vladiclick/emo-desk-robot/emo-complete/Emo-Complete-cutaway.png

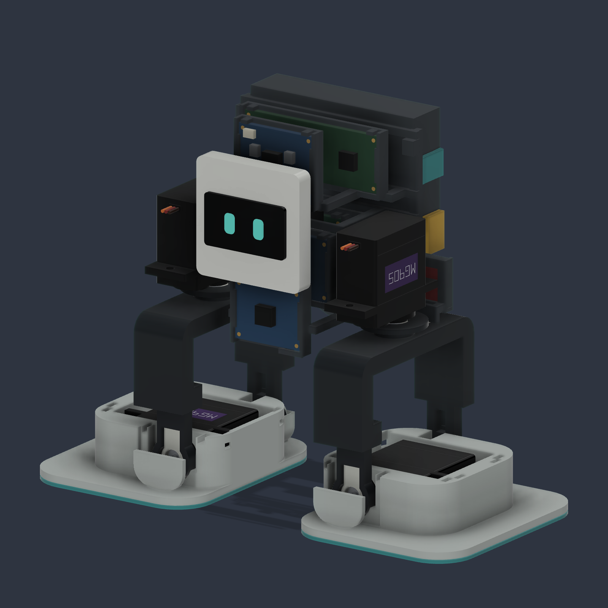
emo-complete/Emo-Complete-cutaway.png
