vladiclick/emo-desk-robot/emo-complete/Emo-Complete-mechanism.png

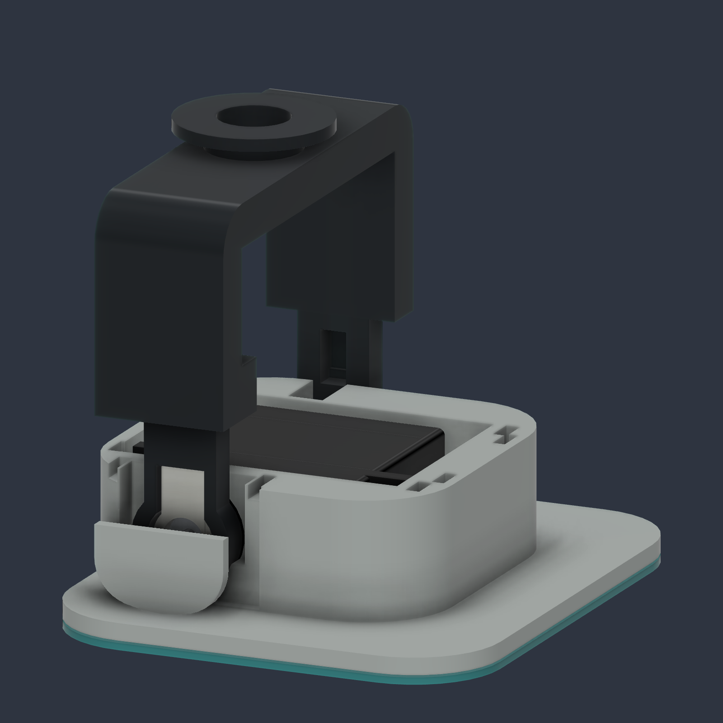
emo-complete/Emo-Complete-mechanism.png
