vladiclick/emo-desk-robot/emo-complete/Emo-Complete-motion.png

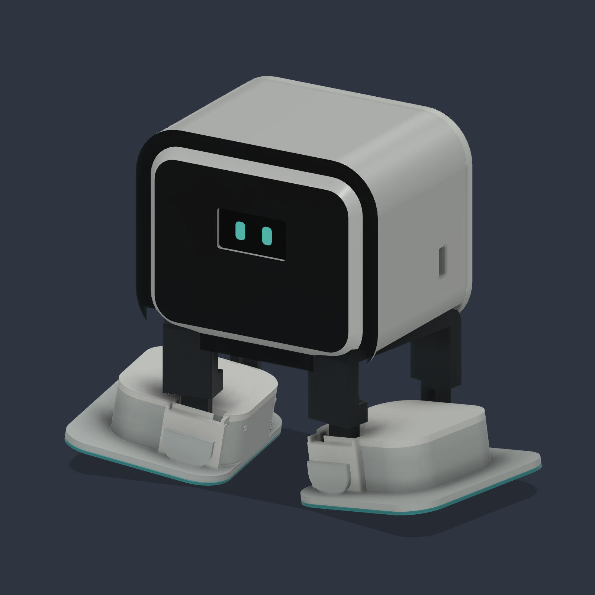
emo-complete/Emo-Complete-motion.png
