vladiclick/emo-desk-robot/emo-complete/Emo-Complete-rear.png

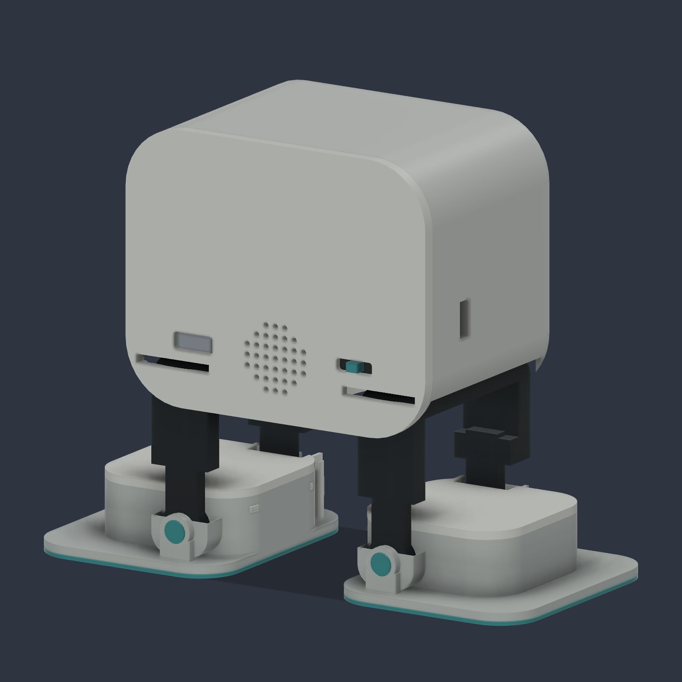
emo-complete/Emo-Complete-rear.png
