vladiclick/emo-desk-robot/emo-complete/Emo-Complete-service.png

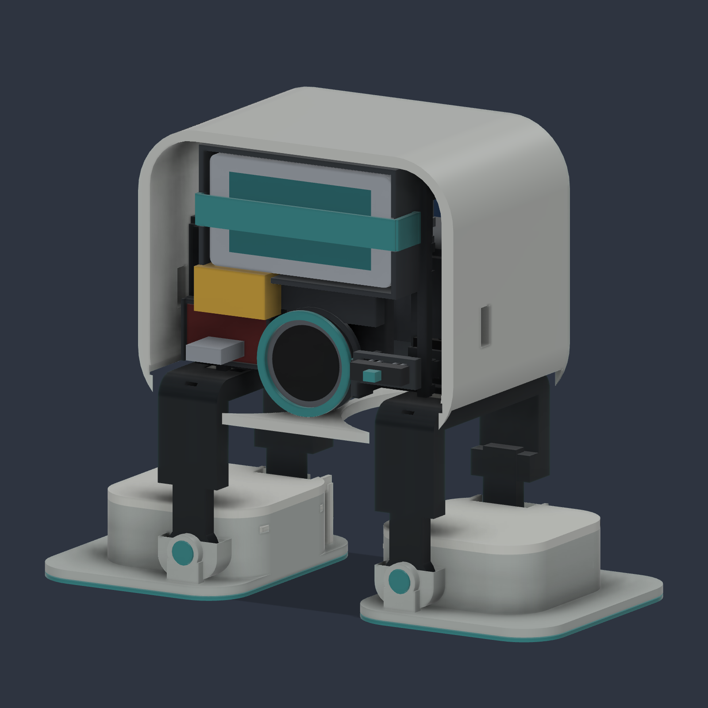
emo-complete/Emo-Complete-service.png
