vladiclick/emo-desk-robot/emo-complete/Emo-Complete-style-Night.png

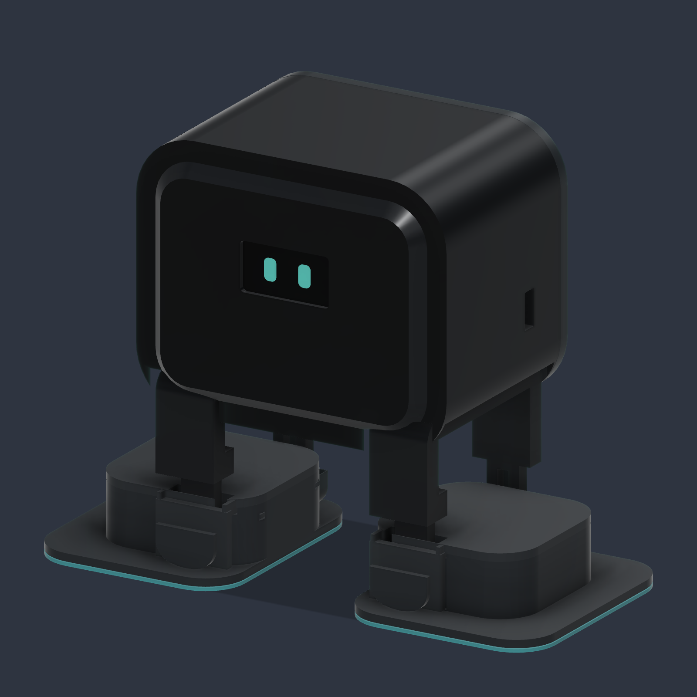
emo-complete/Emo-Complete-style-Night.png
