vladiclick/emo-desk-robot/figurine/EMO_52min_preview.png

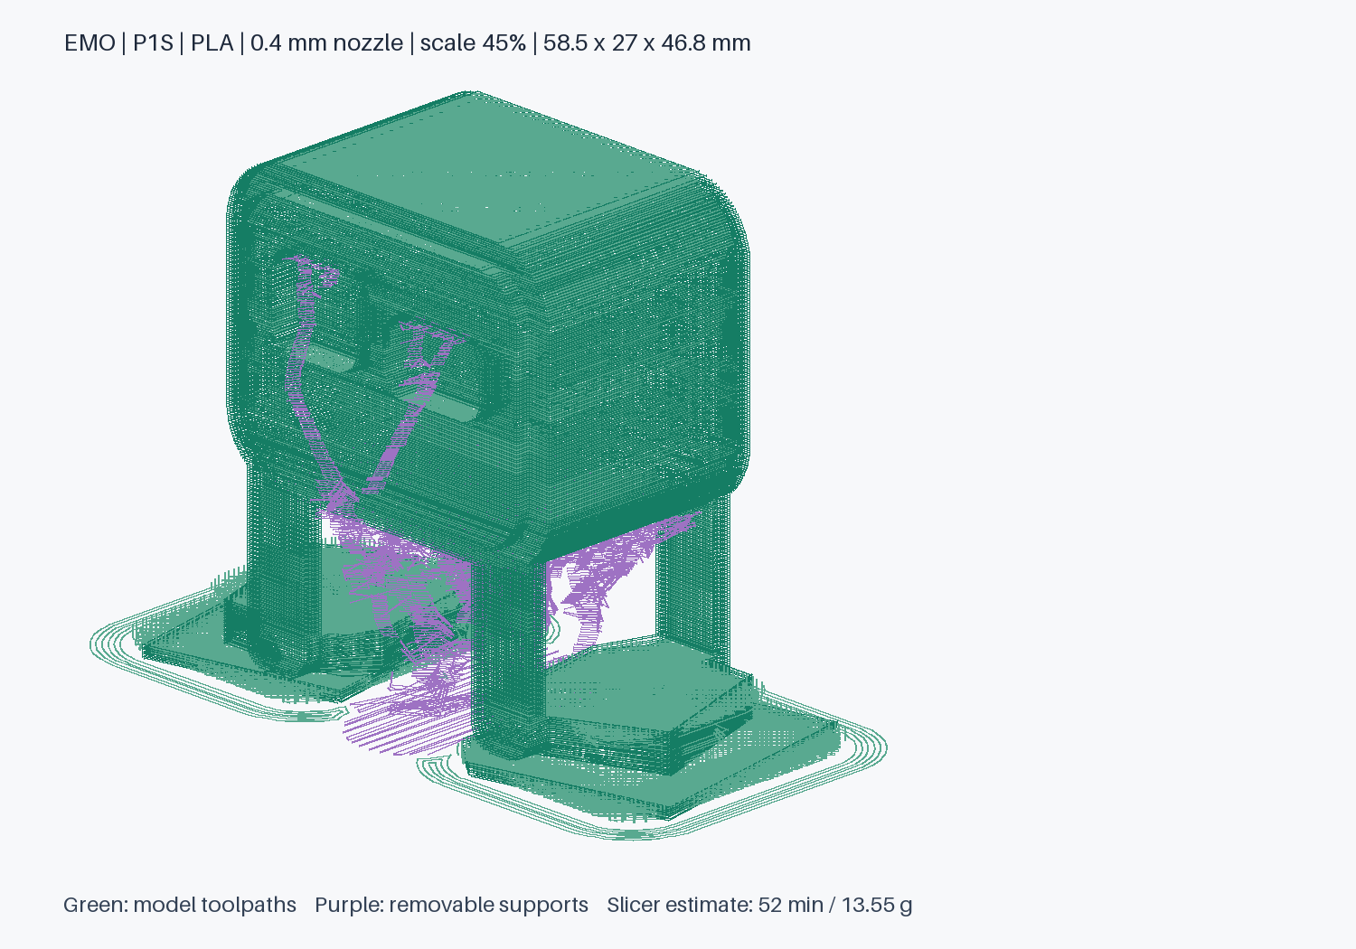
figurine/EMO_52min_preview.png
