vladiclick/emo-desk-robot/variants/4-servo/Emo-4servo-interior.png

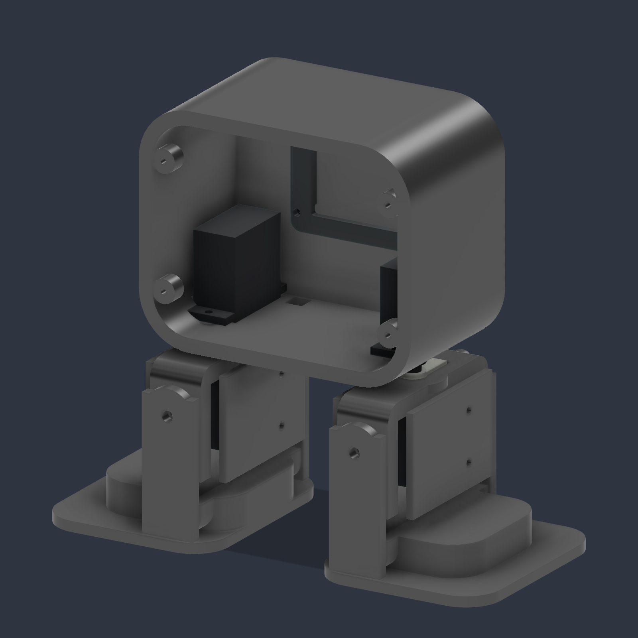
variants/4-servo/Emo-4servo-interior.png
