vladiclick/emo-desk-robot/variants/4-servo/Emo-4servo-joints-demo.png

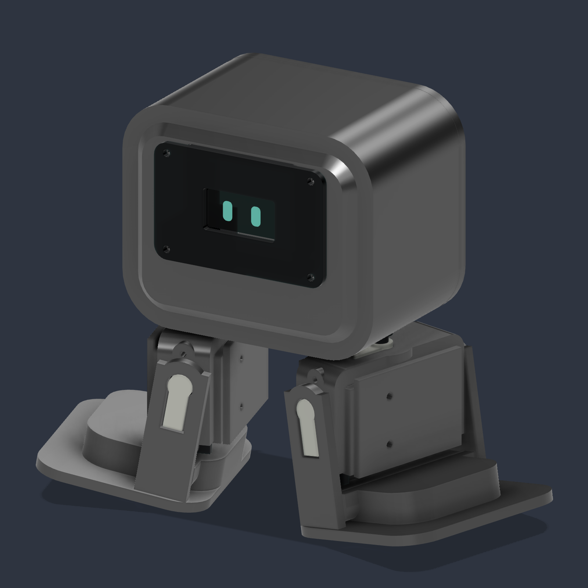
variants/4-servo/Emo-4servo-joints-demo.png
