vladiclick/emo-desk-robot/variants/4-servo/Emo-4servo-preview.png

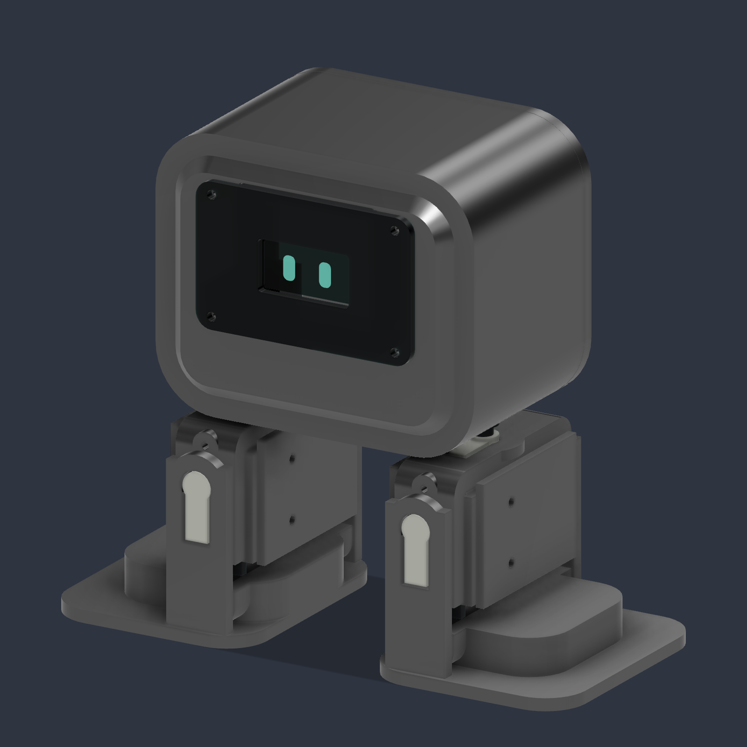
variants/4-servo/Emo-4servo-preview.png
