vladiclick/emo-desk-robot/variants/direct-drive/Emo-DirectDrive-cutaway.png

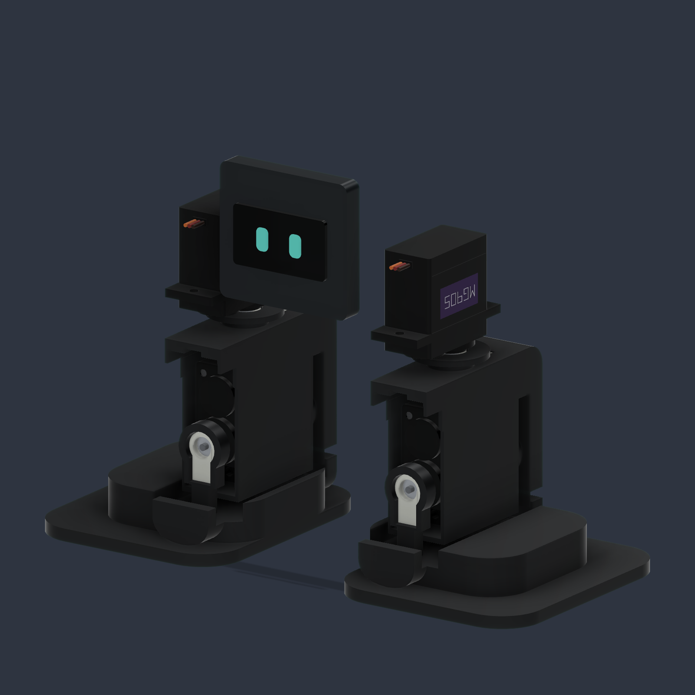
variants/direct-drive/Emo-DirectDrive-cutaway.png
