vladiclick/emo-desk-robot/variants/direct-drive/Emo-DirectDrive-exterior.png

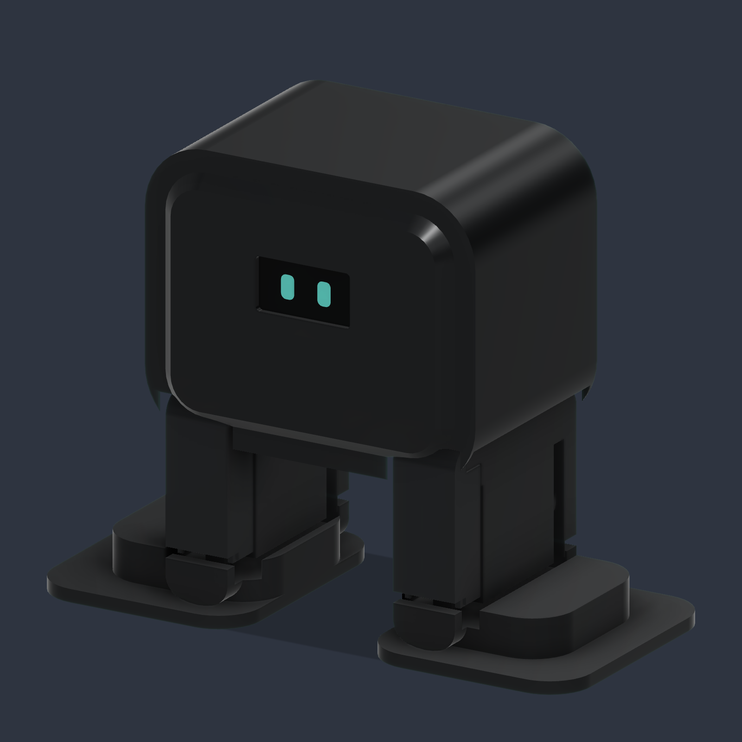
variants/direct-drive/Emo-DirectDrive-exterior.png
