vladiclick/emo-desk-robot/variants/direct-drive/Emo-DirectDrive-mechanism.png

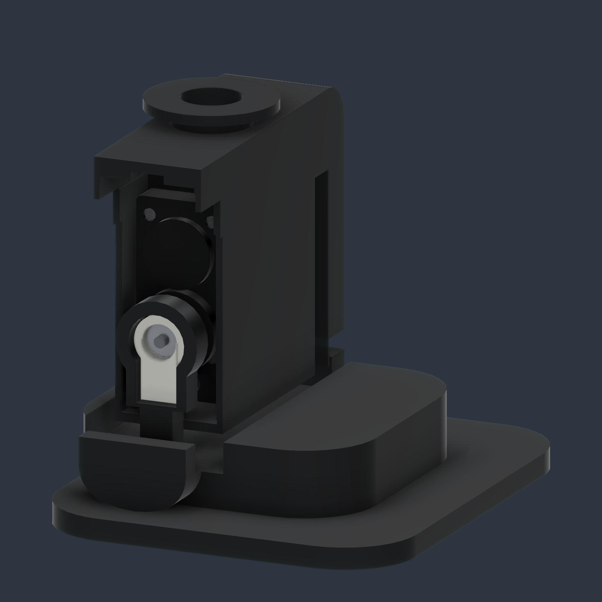
variants/direct-drive/Emo-DirectDrive-mechanism.png
