vladiclick/emo-desk-robot/variants/direct-drive/Emo-DirectDrive-motion.png

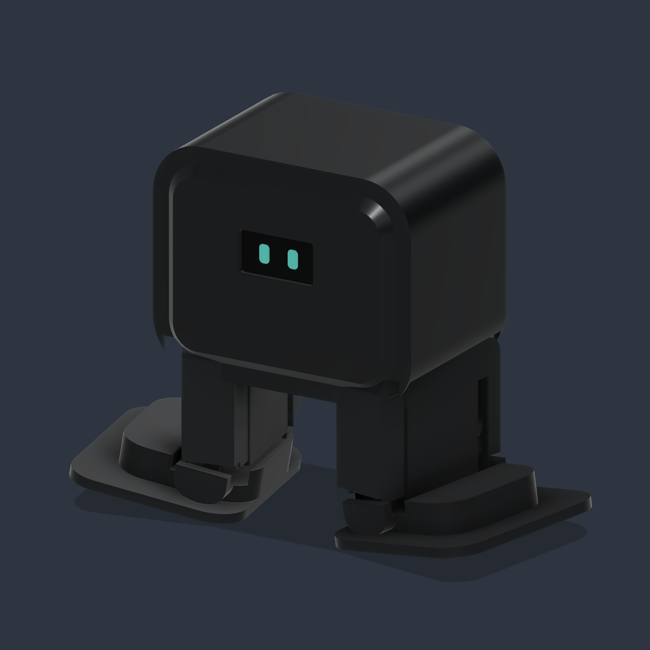
variants/direct-drive/Emo-DirectDrive-motion.png
