vladiclick/emo-desk-robot/variants/foot-drive/Emo-FootDrive-cutaway.png

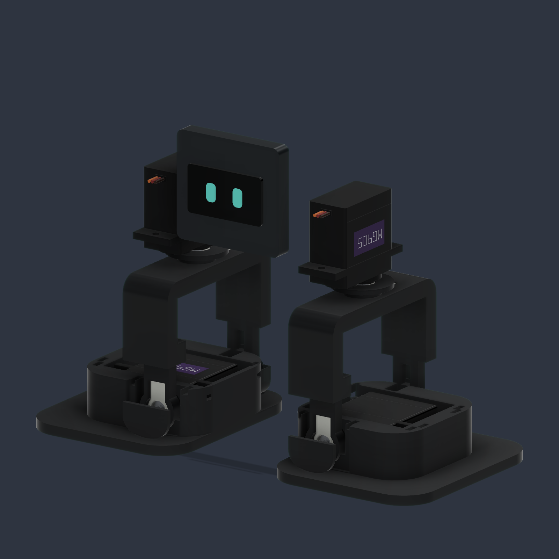
variants/foot-drive/Emo-FootDrive-cutaway.png
