vladiclick/emo-desk-robot/variants/foot-drive/Emo-FootDrive-mechanism.png

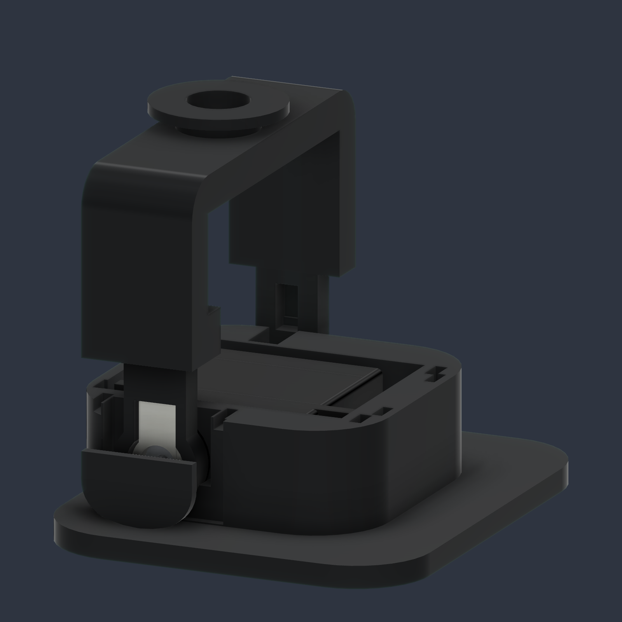
variants/foot-drive/Emo-FootDrive-mechanism.png
