vladiclick/emo-desk-robot/variants/foot-drive/Emo-FootDrive-motion.png

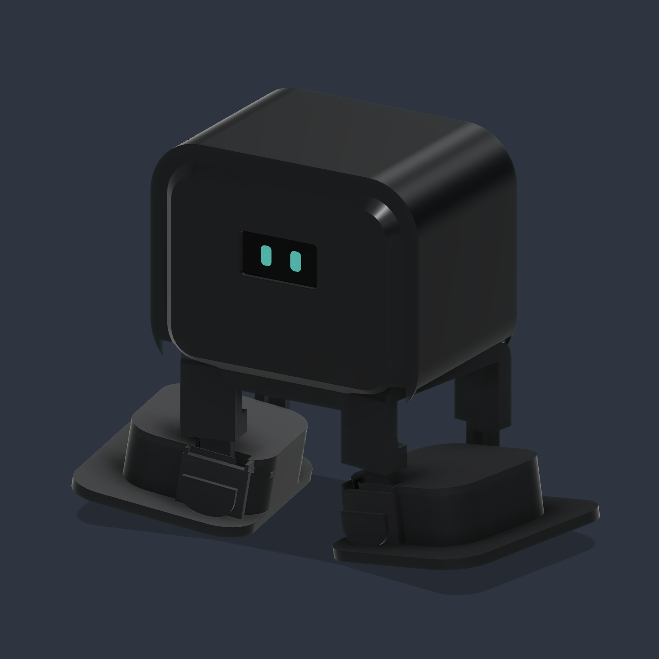
variants/foot-drive/Emo-FootDrive-motion.png
