vladiclick/emo-desk-robot/variants/head-drive/Emo-HeadDrive-interior.png

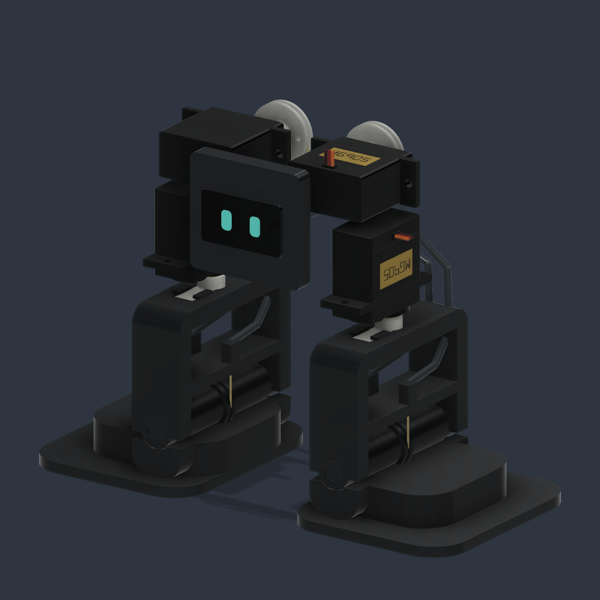
variants/head-drive/Emo-HeadDrive-interior.png
