vladiclick/emo-desk-robot/variants/head-drive/MG90S-detail.png

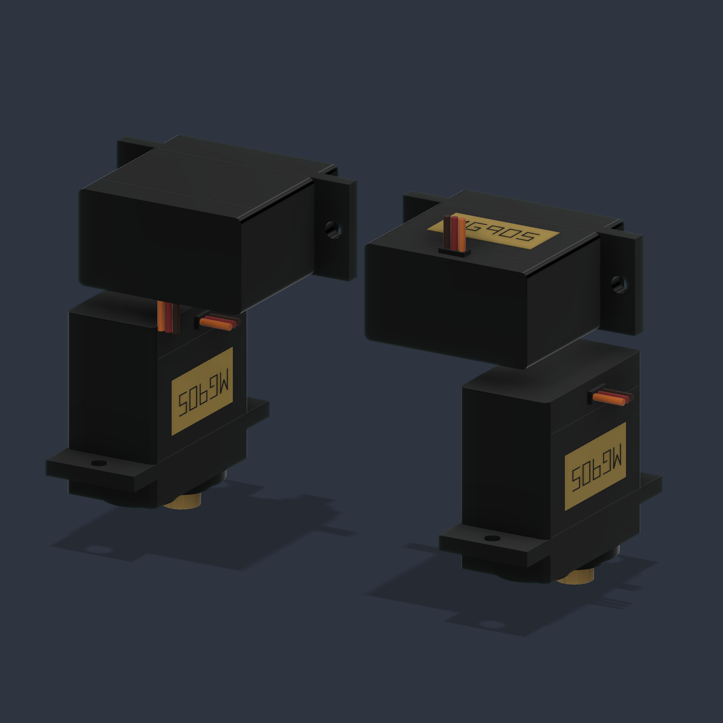
variants/head-drive/MG90S-detail.png
