vladiclick/emo-desk-robot/emo-complete/parts.csv

id | cantitate | unitate | piesa | dimensiuni_mm_sau_rezerva_CAD | statut_dimensional | sursa_primara | cautare_AliExpress | observatii
S01 | 4 | buc | Servo pozițional MG90S 180° | 22.8 × 12.4 × 28.5; urechi 32.5 | Nominal producător; verifică servoul și hornul reale | https://towerpro.com.tw/product/mg90s-3/ | MG90S 180 degree positional servo metal gear | Nu varianta 360°/continuous; 2 șolduri + 2 tălpi
B01 | 1 | buc | Gaoneng GNB6501S70A 1S 650mAh 70C 3.7V, varianta XT30 | 46 × 25 × 8.5; punga fără fire și mufă | Documentat; titlu A30 versus specificații XT30 contradictorii | https://www.gaoneng.shop/products/gaoneng-gnb-1s-3.7v-650mah-70c-xt30-lipo-battery | GNB 650mAh 1S 3.7V 70C XT30 | 4.2V maxim la încărcare; nu LiHV/2S; confirmă mufa SKU; nu comprima punga
E01 | 1 | buc | ESP32-C3 SuperMini USB-C | 22.5 × 18; rezervă CAD grosime 6 | Contur furnizor; înălțime rezervată, nu cotă certificată | https://protosupplies.com/product/esp32c3-supermini/ | ESP32 C3 SuperMini USB C | Fără bare de pini; verifică USB-C și pinout placa primită
D01 | 1 | buc | OLED 0.96 inch SSD1306 I2C 128x64 monocrom | PCB 27 × 27; cabluri joase direct pe paduri | Joy-IT documentează 27 × 27 × 11 cu pini; înălțimea fără pini neconfirmată | https://www.joy-it.net/en/products/SBC-OLED01 | 0.96 SSD1306 I2C 27mm 27mm white OLED | Alege 4 pini I2C; nu SPI 7 pini; verifică PCB, sticlă și poziția ariei active
A01 | 1 | buc | DFPlayer Mini DFR0299 | 20 × 20; rezervă CAD grosime 6 | Contur original documentat; grosime rezervată | https://www.dfrobot.com/product-1121.html | DFPlayer Mini DFR0299 | Fără bare de pini; slotul microSD trebuie să rămână accesibil
A02 | 1 | buc | microSD până la 32GB FAT32 | Potrivit slotului DFPlayer | Cerință modul original | https://www.dfrobot.com/product-1121.html | microSD 8GB 16GB 32GB FAT32 | Nu este necesar card rapid; verifică redarea înainte de închidere
A03 | 1 | buc | Difuzor rotund 8ohm 0.5W, reper PUI AS02008MR-R | Ø20 × 3 | Reper producător; orice clonă trebuie măsurată | https://puiaudio.com/product/speakers-and-receivers/as02008mr-r | 20mm 8ohm 0.5W round speaker | Limitează volumul DFPlayer la puterea difuzorului; nu confunda cu buzzer
P01 | 1 | buc | Pololu U3V70F5 convertor boost 5V | 40.6 × 15.2 × 4.6 fără pini/borne | Documentat producător; curentul depinde de Vin și temperatură | https://www.pololu.com/product/2891 | Pololu U3V70F5 5V boost | Nu presupune 10A la ieșire; testează sarcina de 4 servouri la baterie descărcată
P02 | 1 | buc | DFRobot DFR0668 încărcător LiPo USB-C | 28 × 16.5; rezervă CAD grosime 6 | Contur documentat; grosime rezervată | https://www.dfrobot.com/product-2068.html | DFRobot DFR0668 Type C Lipo charger | Configurează 200mA; 4.2V pentru o singură celulă; nu oferă singur protecția întregului robot
P03 | 1 | buc | Tenergy protecție 1S P/N32195 | 28.8 × 7 × 2.5 | Documentat producător | https://power.tenergy.com/tenergy-1s-li-ion-8-5a-18a-pcb-discharging-cut-off-voltage-2-8v/ | Tenergy 32195 1S 8.5A protection PCB | 8.5A lucru, prag supracurent declarat 18A, cutoff nominal 2.8V; nu substitui DW01/8205 generic fără verificare
I01 | 1 | buc | IMU GY-521 MPU-6050 | Rezervă CAD 20 × 16 × 4 | Contur clonă asumat; neconfirmat prin desenul producătorului plăcii | https://product.tdk.com/en/search/sensor/mortion-inertial/imu/info?part_no=MPU-6050 | GY 521 MPU6050 20mm 16mm | Măsoară PCB și verifică identitatea I2C; alternativa modernă cere suport și firmware adaptate
SW01 | 1 | buc | C&K JS203011CQN DP3T 3 poziții non-shorting | Corp 13 × 3.6 nominal / 3.9 max × 3.5; terminale 3.3±0.4; buton separat | Seria și funcția documentate; rezerva CAD nu este cota corpului | https://www.ckswitches.com/media/1422/js.pdf | JS203011CQN DP3T non shorting | 0.3A la 6V; numai selecție de mod/semnale, niciodată curentul motoarelor; gol central pentru lipituri; rânduri terminale de confirmat; nu reazem pe pini
U01 | 1 | buc | SparkFun USB-C Breakout Vertical BOB-23055 cu flanșă PCB | PCB11.43 × 20.32; total20.32 × 11.43 × 11.70; J2(3.175;10.16), offset-2.54 pe latura scurtă | Contur și poziție Eagle verificate; anvelopă totală documentată SparkFun | https://github.com/sparkfun/SparkFun_USB-C_Vertical_Breakout/tree/main/Hardware | SparkFun BOB 23055 USB C vertical breakout | R1/R2 5.1kΩ CC1/CC2-GND independente integrate; fără Rd suplimentare; reținere pe PCB; fără header; curent USB nu alimentează direct4servouri
J01 | 1 | pereche | Conector XT30 tată + mamă potrivit bateriei | Rezervă pereche 10 × 18 × 7 | Anvelopă de montaj, verifică piesa reală |  | XT30 male female connector genuine | Izolează fiecare terminal și asigură polaritatea; nu confunda XT30 cu A30
W01 | după traseu | set | Fire silicon principale 20–22AWG + tub termocontractabil | Lungimi adaptate la prototip | Alegere de integrare |  | 20 AWG 22 AWG silicone wire heat shrink | Pentru baterie/protecție/boost/bara servo; fire flexibile fine separat la semnale
C01 | 1 | buc | Condensator electrolitic 470uF minimum6.3V | Rezervă CAD Ø8 × 12 | Anvelopă rezervată; verifică seria aleasă |  | 470uF 6.3V low ESR capacitor 8mm 12mm | Pe bara 5V lângă distribuția servo; respectă polaritatea; nu înlocuiește sursa corectă
C02 | 1 | buc | Condensator electrolitic 33uF minimum6.3V | Măsoară seria aleasă | Recomandare producător boost pentru amortizare |  | 33uF 6.3V capacitor | Pe intrarea boost cu fire scurte
C03 | 1 | buc | Condensator electrolitic 100uF minimum6.3V | Măsoară seria aleasă | Decuplare ESP de integrare |  | 100uF 6.3V low ESR capacitor | Lângă ESP după izolarea cu SS34; verifică polaritatea
C04 | 1 | buc | Condensator ceramic 100nF | Montaj lângă ADC | Filtru divizor măsurare baterie |  | 100nF ceramic capacitor | ADC la GND; nu pe firul PWM
R01 | 5 | buc | Rezistor 1kohm | Montaj izolat | 4 PWM plus 1 UART RX DFPlayer |  | 1k ohm resistor | Câte unul pe semnalul fiecărui servo; unul pe ESP TX către RX DFPlayer
R02 | 6 | buc | Rezistor 100kohm | Montaj izolat | 4 pulldown PWM plus 2 pentru divizor ADC |  | 100k ohm resistor 1 percent | Patru pulldown spre GND; două 100k pentru divizor 1:2
Q01 | 1 | buc | Diodă Schottky SS34 | Capsulă conform fișei variantei cumpărate; de măsurat | Componentă electrică de integrare |  | SS34 Schottky diode | Izolare intrare alimentare ESP conform schemei; verifică orientarea și tensiunea disponibilă
M01 | 2 | buc | Ax posterior scurt din oțel Ø3mm | Lungime după locașurile din modelul curent | Hardware mecanic |  | 3mm steel dowel pin | Debavurat; pivot posterior independent, nu ax prin servo
M02 | 4 | buc | Șurub central original pentru horn MG90S | Conform setului servo primit | Singurele patru șuruburi de asamblare ascunse |  | MG90S servo horn screw | Nu înlocui cu autofiletant imprimat; verifică filetul arborelui real
M03 | 4 | buc | Horn original compatibil MG90S | Conform buzunarelor modelate | Compatibilitatea reală trebuie probată |  | MG90S single arm servo horn | Inclus de regulă la servo; verifică canelurile și brațul, nu cumpăra după simpla denumire
F01 | după necesar | foaie | Spumă moale adezivă 0.5mm | Grosime 0.5 | Material integrare |  | 0.5mm adhesive foam sheet | Antizgomot și sprijin moale; nu presa bateria și nu atinge membrana difuzorului
F02 | după STL | set | PETG pentru piesele rigide | Piese ale variantei Emo-Complete | Piese de printat |  | PETG filament | Probați clipsurile și locașul unui servo înainte de întregul set
F03 | 2 | buc printat | Tălpi de aderență TPU | După STL curent | Piese de printat |  | TPU filament | Pentru cele două picioare; verifică aderența pe suprafața de test
F04 | 1 | buc printat | Reținător difuzor TPU | După STL curent | Piesă de printat |  | TPU filament | Reține doar rama difuzorului, nu membrana
F05 | 1 | buc printat | Punte de retenție baterie TPU | După STL curent | Piesă de printat |  | TPU filament | Retenție ușoară cu joc; fără strângerea sau perforarea pungii LiPo
M04 | 1 | buc | Colier nylon mini pentru condensator | Lățime2.5; lungime adaptată ghidajelor și Ø8mm | Consumabil; verifică dimensiunea capului în locaș |  | 2.5mm mini nylon cable tie | Retenție condensator470uF; strângere moderată; nu utiliza pe punga LiPo
