vladiclick/emo-desk-robot/emo-complete/Emo-Complete-print.step

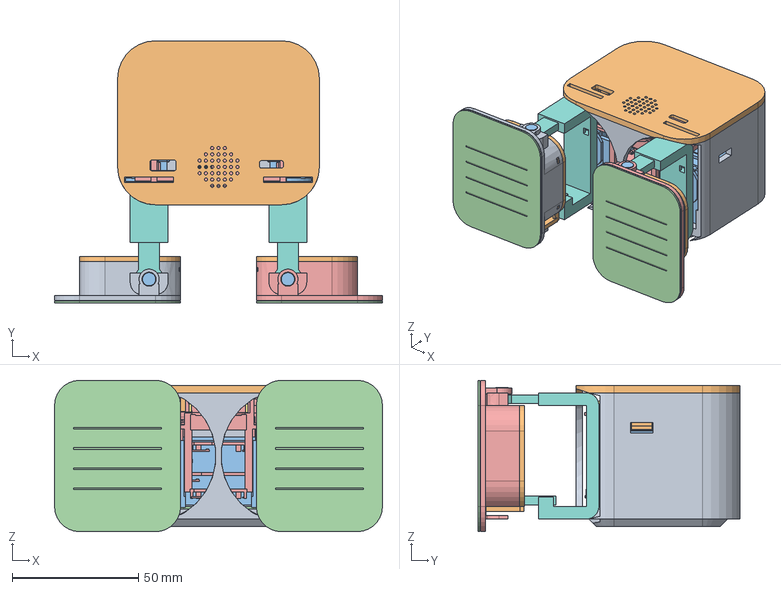
[picture p22: CAD file, 2026-10-26]
emo-complete/Emo-Complete-print.step
130.0 x 104.0 x 60.0 mm
