vladiclick/emo-desk-robot/emo-complete/Foot_R_-_TPU_traction_sole.stl

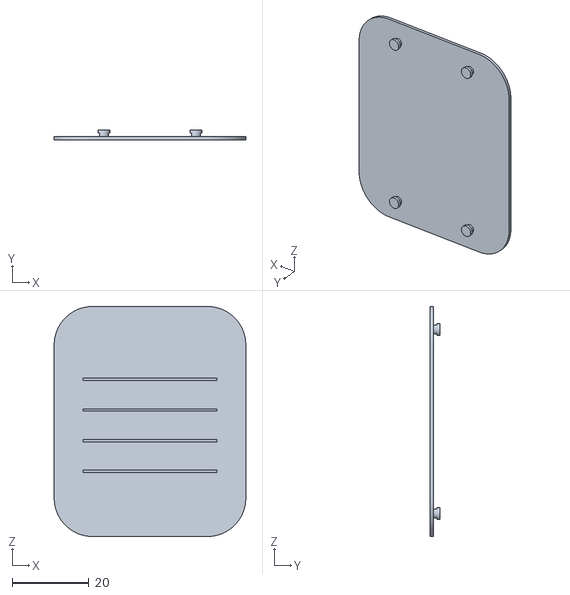
[picture p23: CAD file, 2026-10-26]
emo-complete/Foot_R_-_TPU_traction_sole.stl
50.0 x 2.50 x 60.0
