vladiclick/emo-desk-robot/figurine/EMO_P1S_PLA_45pct_52min.3mf

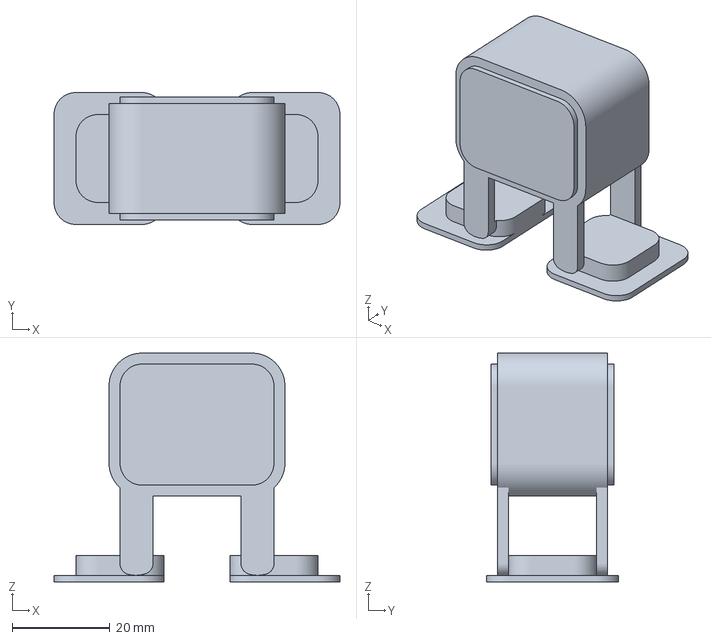
[picture p24: CAD file, 2026-10-26]
figurine/EMO_P1S_PLA_45pct_52min.3mf
58.5 x 27.0 x 46.8 mm
