vladiclick/emo-desk-robot/variants/4-servo/Emo-4servo.step

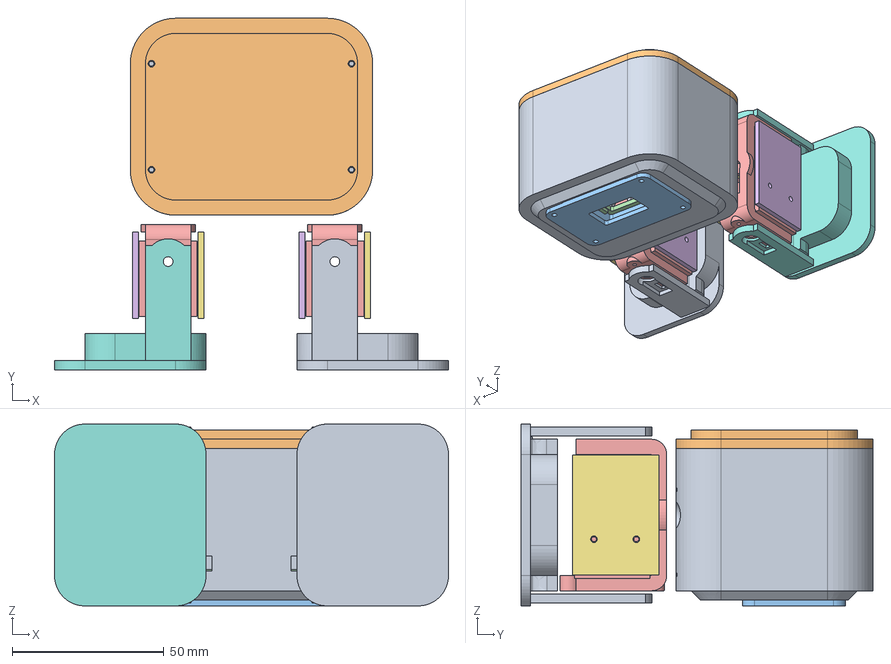
[picture p25: CAD file, 2026-10-26]
variants/4-servo/Emo-4servo.step
130.0 x 116.0 x 60.0 mm
