vladiclick/emo-desk-robot/variants/direct-drive/Foot_R_-_direct_keyed_drive.stl

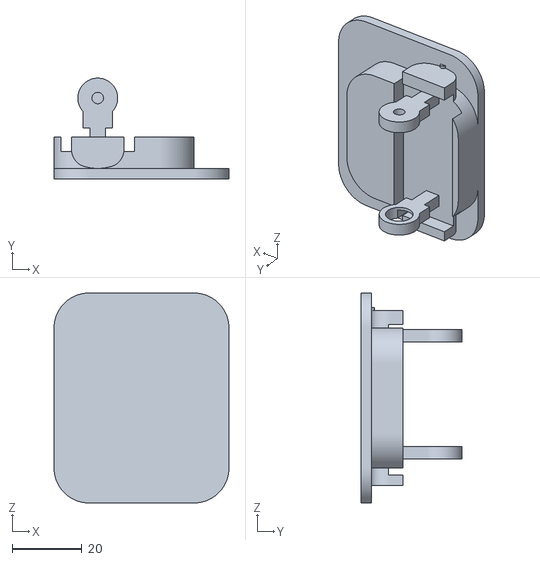
[picture p26: CAD file, 2026-10-26]
variants/direct-drive/Foot_R_-_direct_keyed_drive.stl
50.0 x 28.8 x 60.0
