vladiclick/emo-desk-robot/variants/foot-drive/Foot_L_-_top_access_lid.stl

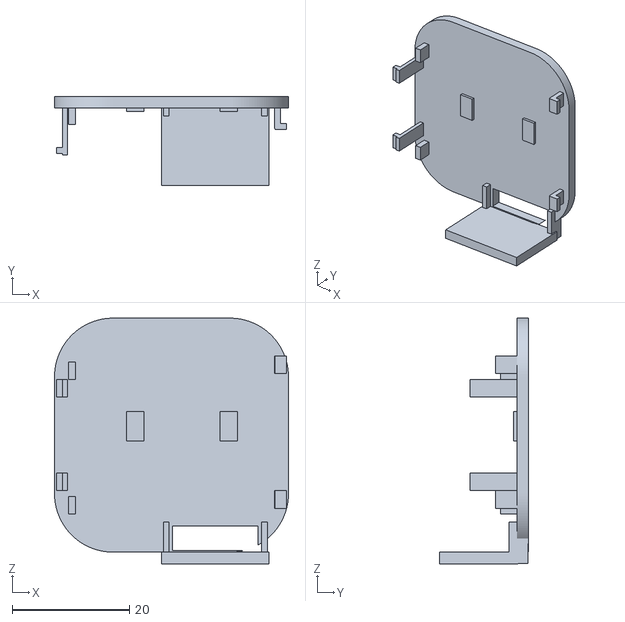
[picture p27: CAD file, 2026-10-26]
variants/foot-drive/Foot_L_-_top_access_lid.stl
40.0 x 15.2 x 42.0
