vladiclick/emo-desk-robot/variants/head-drive/Original_foot_L_with_concealed_pulley.stl

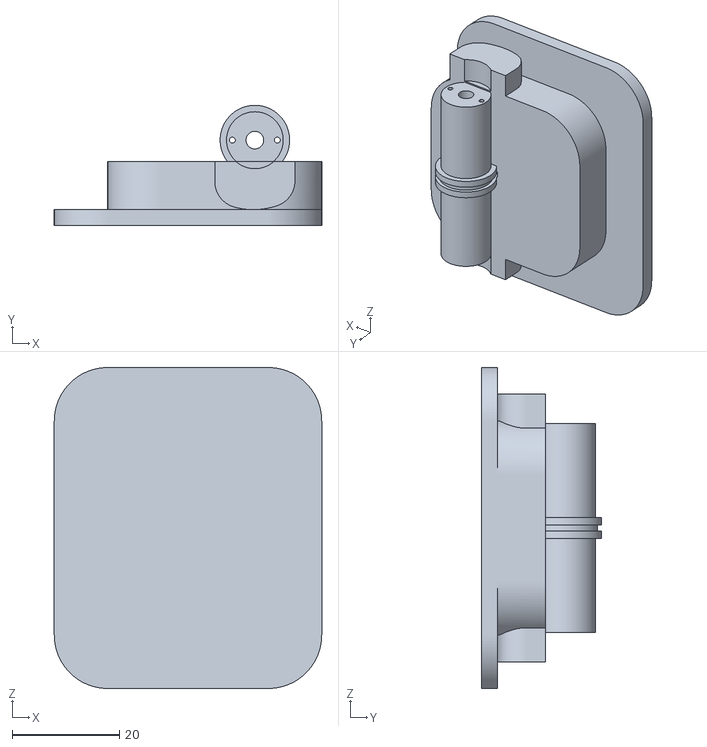
[picture p28: CAD file, 2026-10-26]
variants/head-drive/Original_foot_L_with_concealed_pulley.stl
50.0 x 22.5 x 60.0
