vladiclick/emo-desk-robot/figurine/EMO_P1S_PLA_60pct_1h23m.3mf

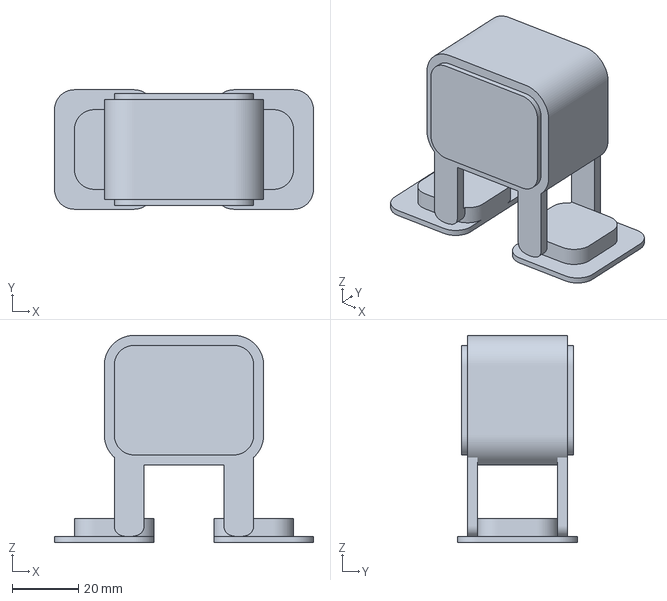
[picture p29: CAD file, 2026-10-26]
figurine/EMO_P1S_PLA_60pct_1h23m.3mf
78.0 x 36.0 x 62.4 mm
