vladiclick/emo-desk-robot/variants/4-servo/User_head_-_rear_service_lid.stl

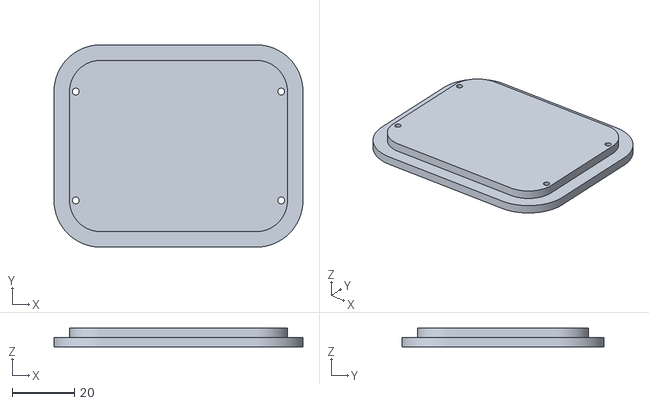
[picture p30: CAD file, 2026-10-26]
variants/4-servo/User_head_-_rear_service_lid.stl
80.0 x 65.0 x 6.00
