vladiclick/emo-desk-robot/variants/direct-drive/Foot_L_-_TPU_rear_axle_cap.stl

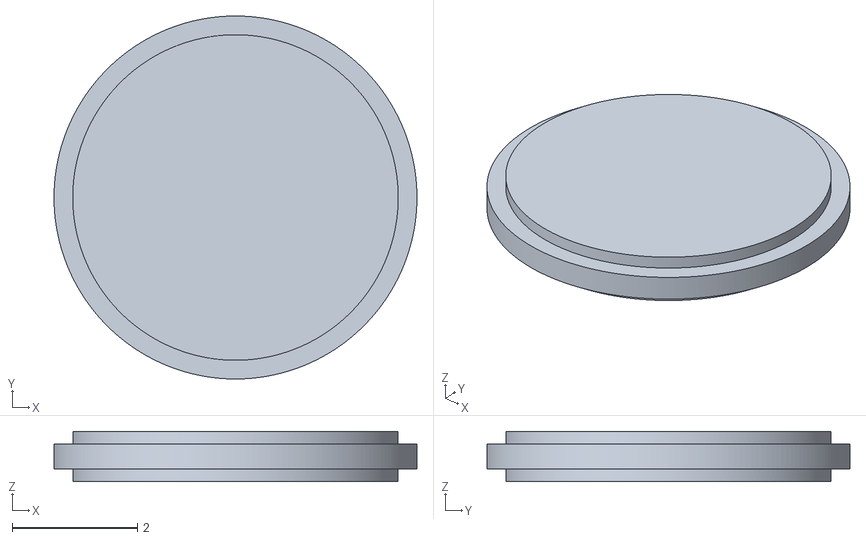
[picture p31: CAD file, 2026-10-26]
variants/direct-drive/Foot_L_-_TPU_rear_axle_cap.stl
5.80 x 5.80 x 0.8
