vladiclick/emo-desk-robot/variants/foot-drive/Emo-FootDrive-print.step

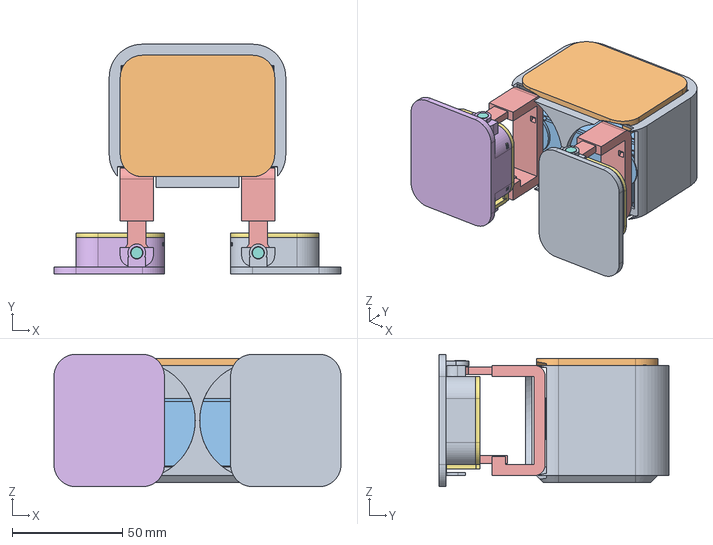
[picture p32: CAD file, 2026-10-26]
variants/foot-drive/Emo-FootDrive-print.step
130.0 x 104.0 x 60.0 mm
