vladiclick/emo-desk-robot/emo-complete/Two_hip_servo_clip_rack.stl

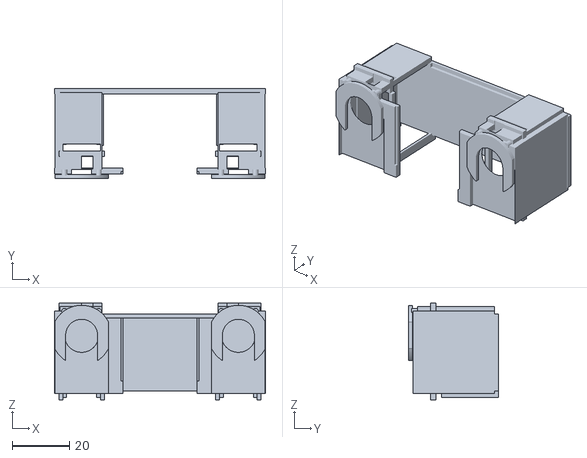
[picture p33: CAD file, 2026-10-26]
emo-complete/Two_hip_servo_clip_rack.stl
74.0 x 31.7 x 34.0
