vladiclick/emo-desk-robot/variants/4-servo/User_foot_R_-_ankle_fork.stl

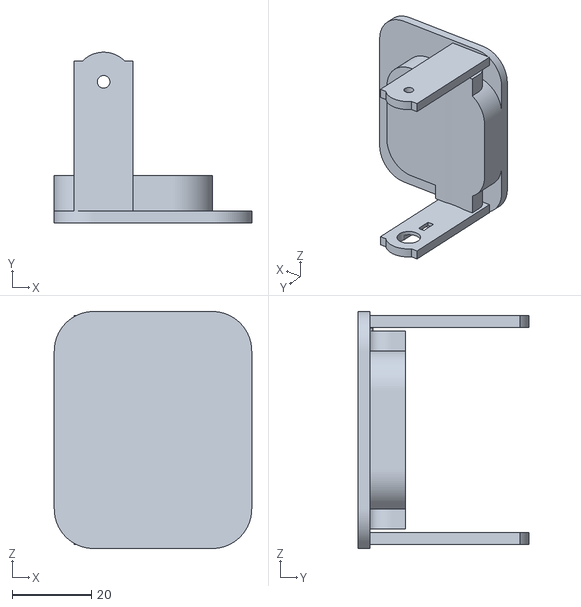
[picture p34: CAD file, 2026-10-26]
variants/4-servo/User_foot_R_-_ankle_fork.stl
50.0 x 43.2 x 60.0
