vladiclick/emo-desk-robot/variants/direct-drive/Leg_L_-_enclosed_direct_MG90S.stl

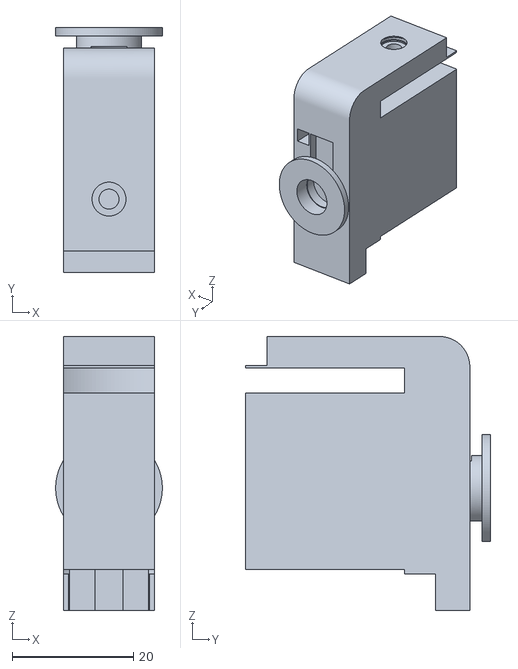
[picture p35: CAD file, 2026-10-26]
variants/direct-drive/Leg_L_-_enclosed_direct_MG90S.stl
17.6 x 40.4 x 45.2
