vladiclick/emo-desk-robot/variants/foot-drive/Foot_R_-_enclosed_flat_MG90S_shoe.stl

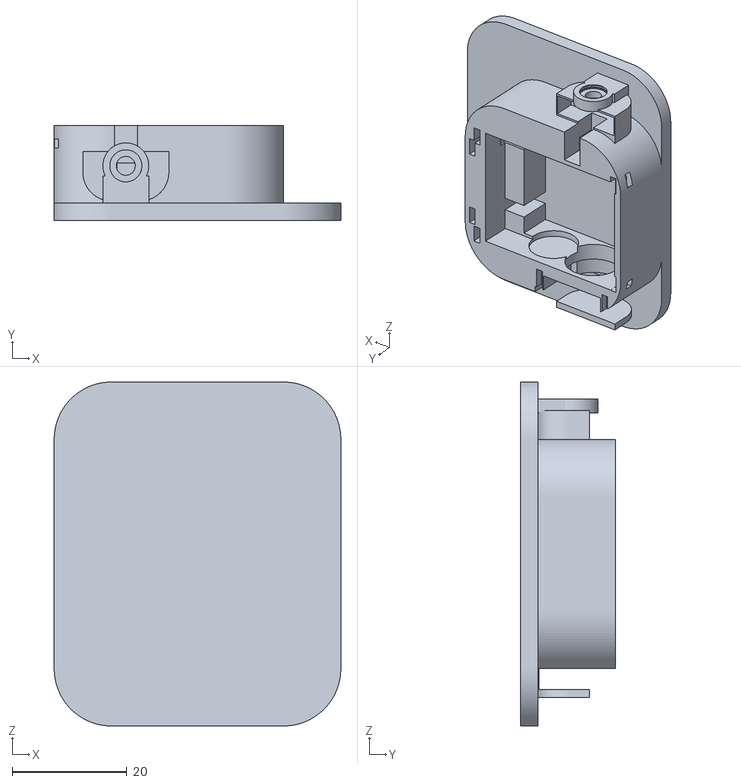
[picture p36: CAD file, 2026-10-26]
variants/foot-drive/Foot_R_-_enclosed_flat_MG90S_shoe.stl
50.0 x 16.5 x 60.0
