vladiclick/emo-desk-robot/variants/head-drive/Removable_four-servo_snap_rack.stl

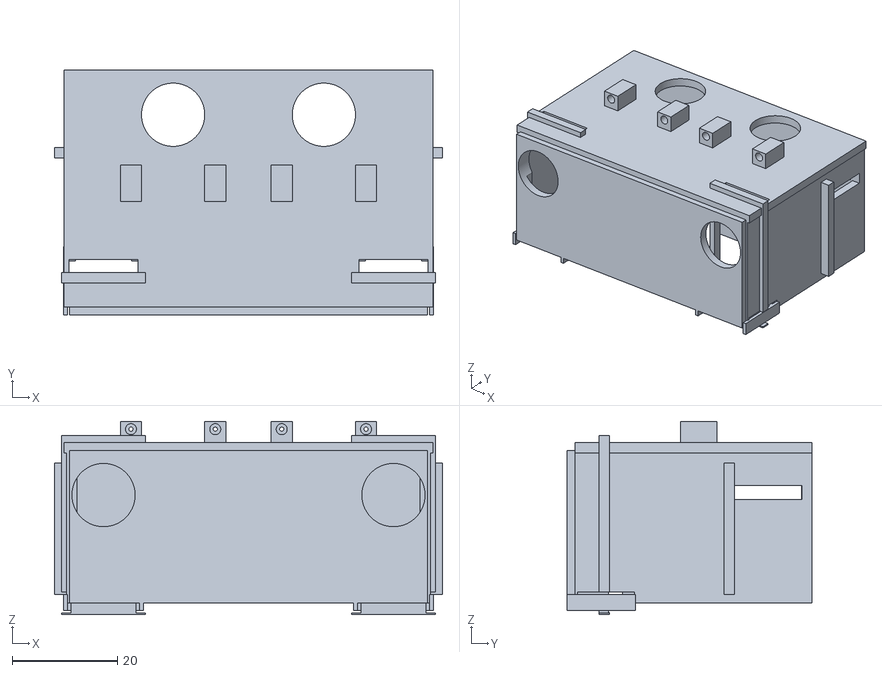
[picture p37: CAD file, 2026-10-26]
variants/head-drive/Removable_four-servo_snap_rack.stl
73.6 x 46.5 x 36.7
