vladiclick/emo-desk-robot/emo-complete/Leg_L_-_slim_open_U_fork.stl

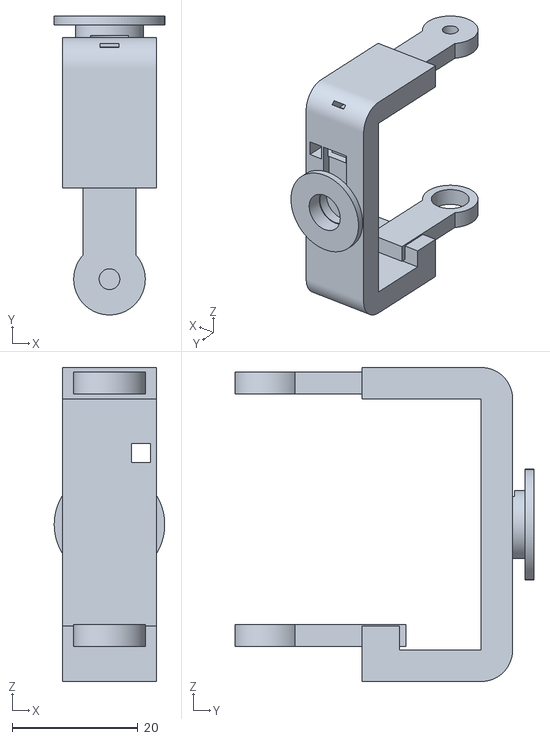
[picture p38: CAD file, 2026-10-26]
emo-complete/Leg_L_-_slim_open_U_fork.stl
17.6 x 47.6 x 50.0
