vladiclick/emo-desk-robot/variants/head-drive/OLED_hidden_slide_carrier.stl

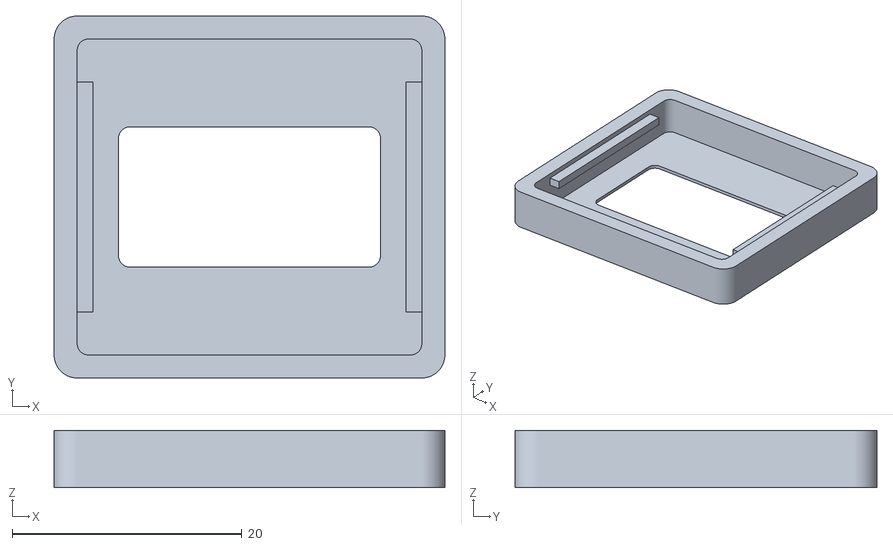
[picture p39: CAD file, 2026-10-26]
variants/head-drive/OLED_hidden_slide_carrier.stl
34.0 x 31.5 x 5.00
