vladiclick/emo-desk-robot/variants/4-servo/Leg_R_side_cover_-1.stl

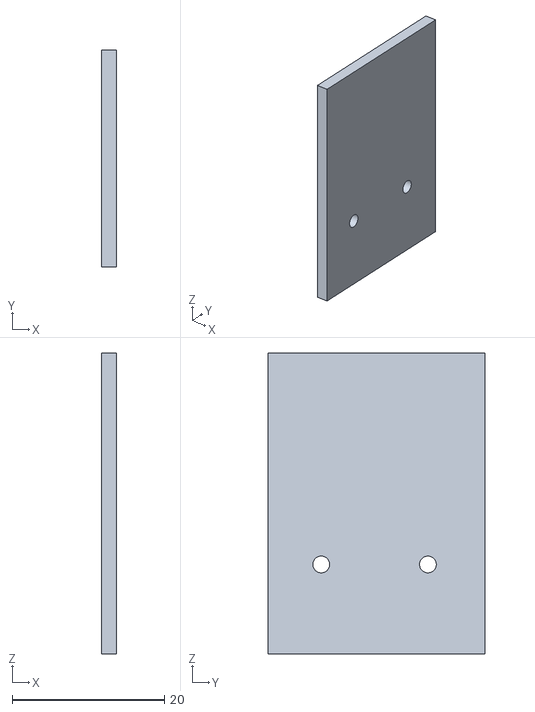
[picture p40: CAD file, 2026-10-26]
variants/4-servo/Leg_R_side_cover_-1.stl
2.00 x 28.5 x 39.5
