vladiclick/emo-desk-robot/variants/direct-drive/Two_hip_servo_clip_rack.stl

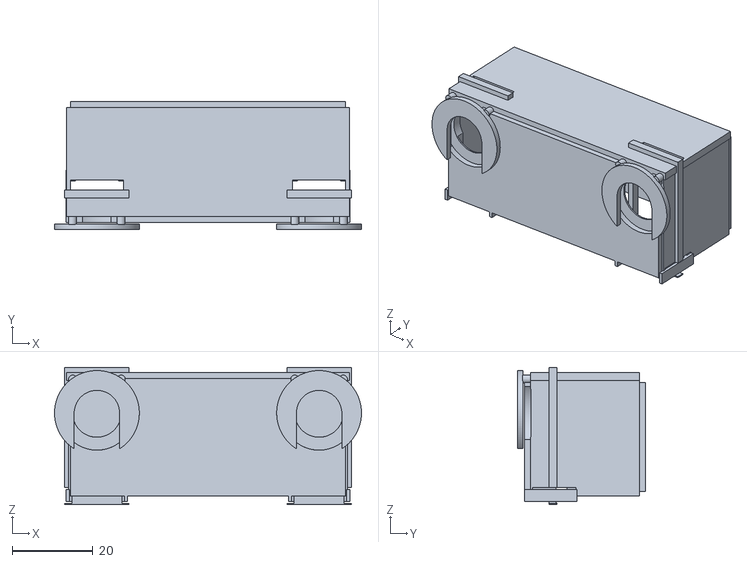
[picture p41: CAD file, 2026-10-26]
variants/direct-drive/Two_hip_servo_clip_rack.stl
76.0 x 31.7 x 34.0
