vladiclick/emo-desk-robot/variants/4-servo/User_leg_L_-_servo_cradle.stl

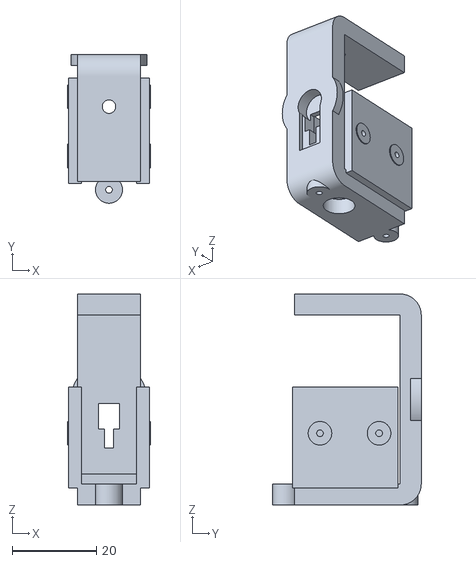
[picture p42: CAD file, 2026-10-26]
variants/4-servo/User_leg_L_-_servo_cradle.stl
19.6 x 35.2 x 50.0
