vladiclick/emo-desk-robot/emo-complete/TPU_speaker_rim_retainer.stl

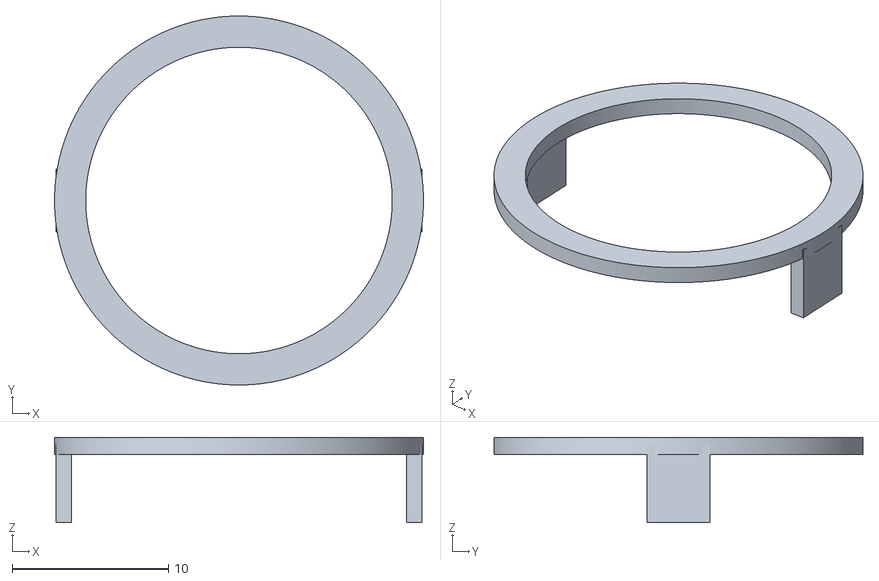
[picture p43: CAD file, 2026-10-26]
emo-complete/TPU_speaker_rim_retainer.stl
23.6 x 23.6 x 5.45
