vladiclick/emo-desk-robot/variants/4-servo/User_head_-_hollow_torso.stl

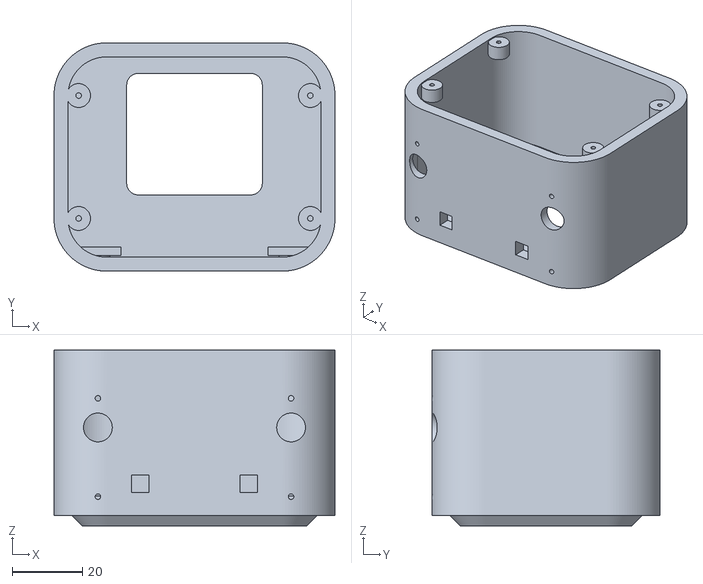
[picture p44: CAD file, 2026-10-26]
variants/4-servo/User_head_-_hollow_torso.stl
80.0 x 65.0 x 50.0
