vladiclick/emo-desk-robot/variants/head-drive/Remote_ankle_drive_drum_L.stl

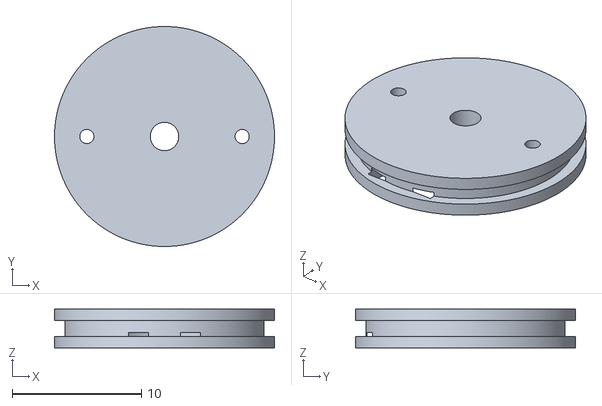
[picture p45: CAD file, 2026-10-26]
variants/head-drive/Remote_ankle_drive_drum_L.stl
17.0 x 17.0 x 3.00
