vladiclick/emo-desk-robot/emo-complete/Foot_L_-_enclosed_flat_MG90S_shoe.stl

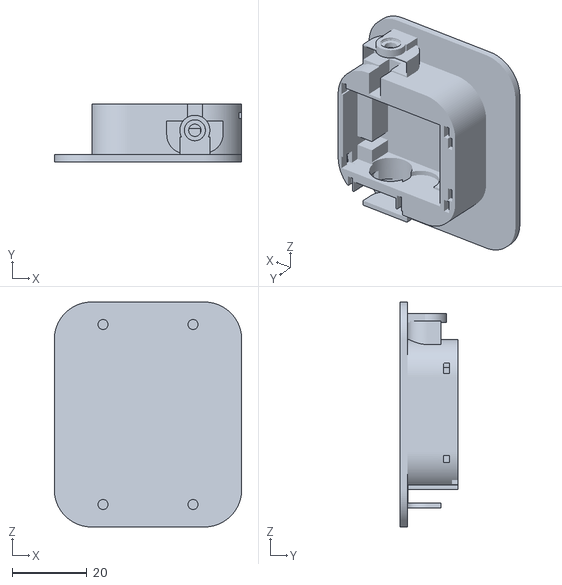
[picture p46: CAD file, 2026-10-26]
emo-complete/Foot_L_-_enclosed_flat_MG90S_shoe.stl
50.0 x 15.5 x 60.0
