vladiclick/emo-desk-robot/variants/4-servo/OLED_PCB_retaining_frame.stl

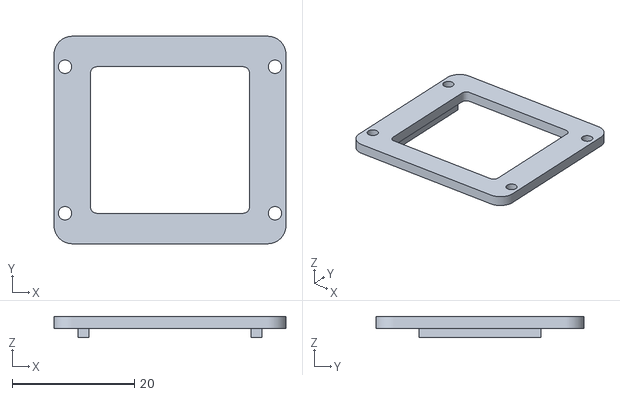
[picture p47: CAD file, 2026-10-26]
variants/4-servo/OLED_PCB_retaining_frame.stl
38.0 x 34.0 x 3.50
