vladiclick/emo-desk-robot/variants/direct-drive/Leg_R_-_clip_front_cover.stl

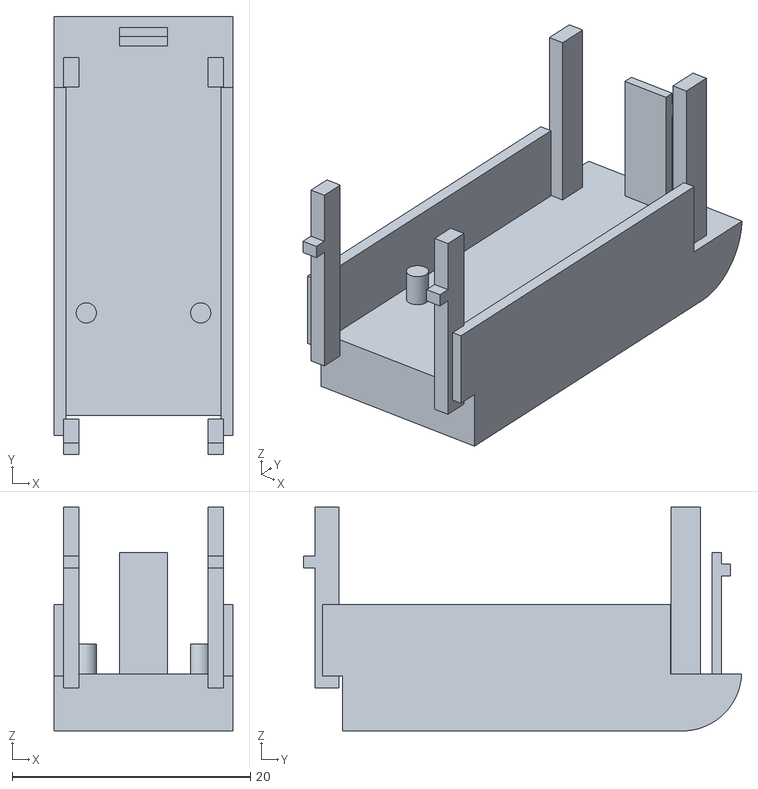
[picture p48: CAD file, 2026-10-26]
variants/direct-drive/Leg_R_-_clip_front_cover.stl
15.0 x 36.8 x 18.8
