vladiclick/emo-desk-robot/variants/4-servo/OLED_0.96_removable_face_carrier.stl

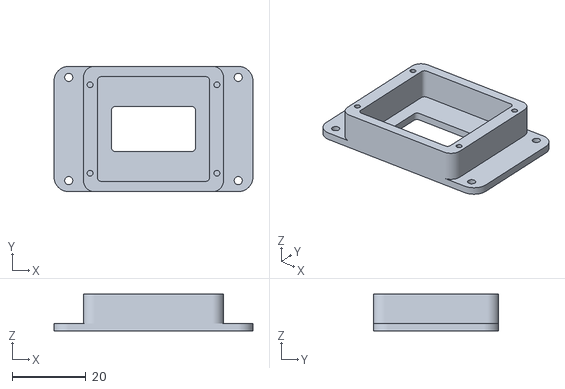
[picture p49: CAD file, 2026-10-26]
variants/4-servo/OLED_0.96_removable_face_carrier.stl
54.0 x 34.0 x 10.0
