vladiclick/emo-desk-robot/variants/direct-drive/Rear_lid_-_four_release_clips.stl

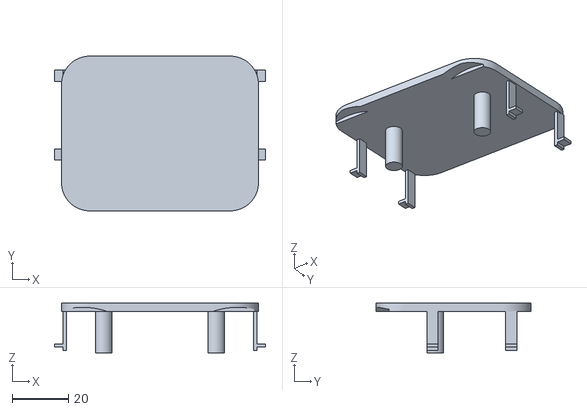
[picture p50: CAD file, 2026-10-26]
variants/direct-drive/Rear_lid_-_four_release_clips.stl
75.0 x 55.0 x 17.7
