vladiclick/emo-desk-robot/emo-complete/Rear_lid_-_two_squeeze_releases.stl

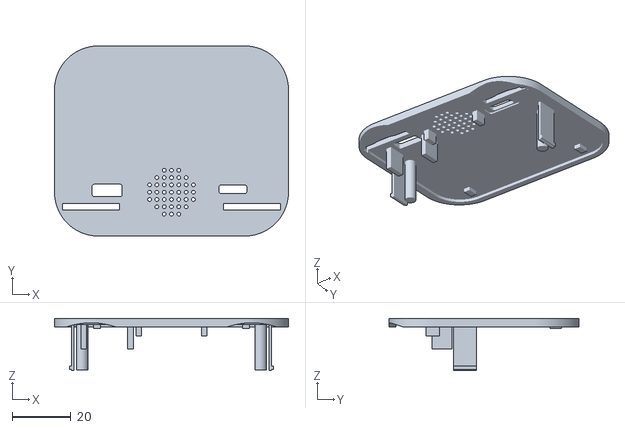
[picture p51: CAD file, 2026-10-26]
emo-complete/Rear_lid_-_two_squeeze_releases.stl
80.0 x 65.0 x 17.8
