vladiclick/emo-desk-robot/variants/head-drive/Rear_lid_-_four_release_clips.stl

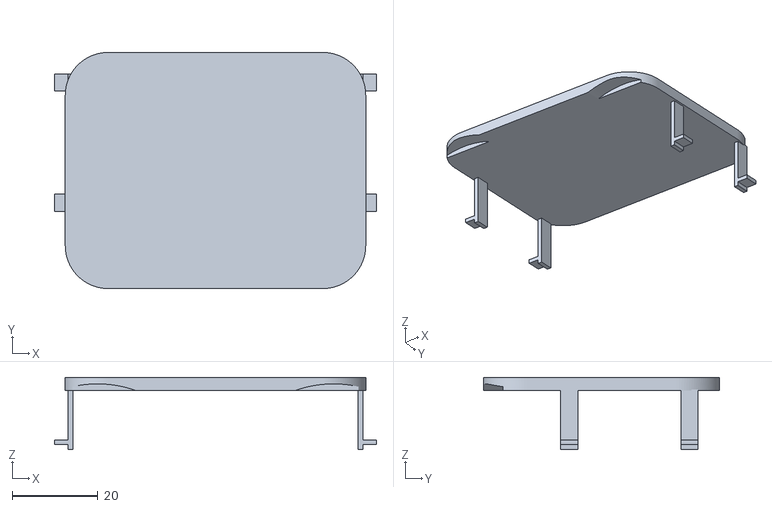
[picture p52: CAD file, 2026-10-26]
variants/head-drive/Rear_lid_-_four_release_clips.stl
75.0 x 55.0 x 16.8
