vladiclick/emo-desk-robot/emo-complete/OLED_hidden_slide_carrier.stl

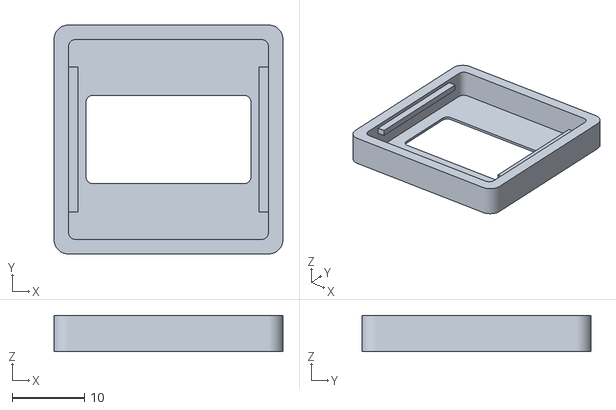
[picture p53: CAD file, 2026-10-26]
emo-complete/OLED_hidden_slide_carrier.stl
31.6 x 31.6 x 5.00
