vladiclick/emo-desk-robot/variants/head-drive/Original_slim_leg_R.stl

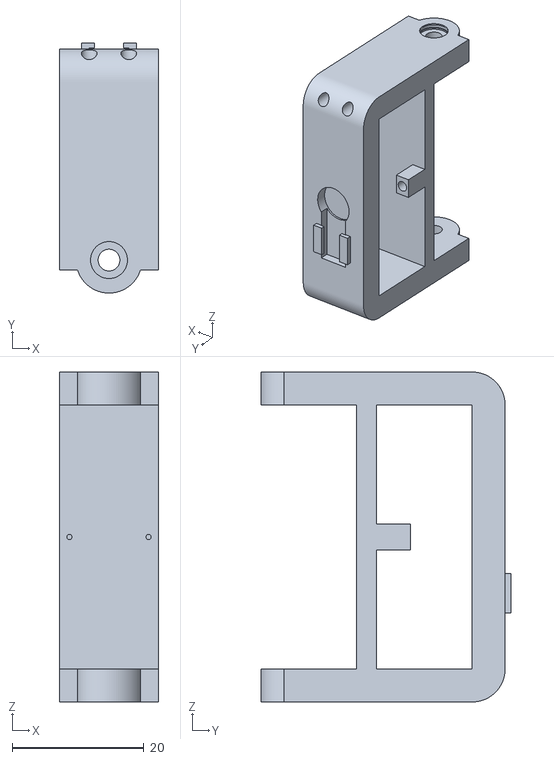
[picture p54: CAD file, 2026-10-26]
variants/head-drive/Original_slim_leg_R.stl
15.0 x 37.9 x 50.0
