vladiclick/emo-desk-robot/emo-complete/Removable_electronics_and_padded_battery_carrier.stl

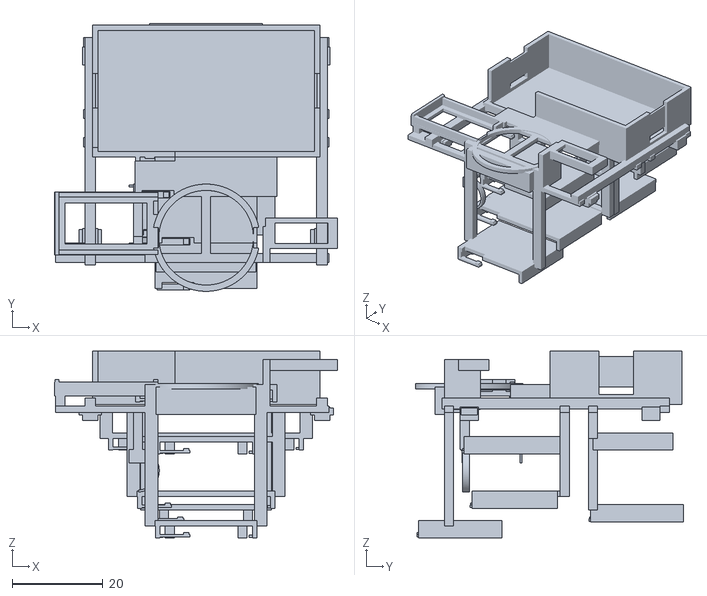
[picture p55: CAD file, 2026-10-26]
emo-complete/Removable_electronics_and_padded_battery_carrier.stl
62.3 x 58.9 x 41.1
