vladiclick/emo-desk-robot/emo-complete/TPU_loose_battery_retaining_bridge.stl

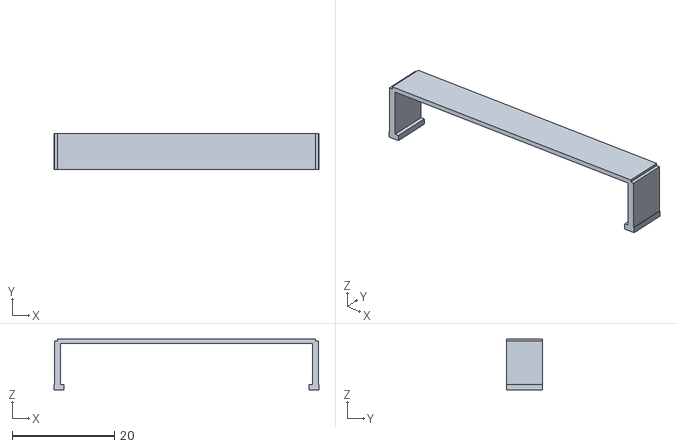
[picture p56: CAD file, 2026-10-26]
emo-complete/TPU_loose_battery_retaining_bridge.stl
51.8 x 7.00 x 9.90
