vladiclick/emo-desk-robot/(list of files, cad)

Other CAD files:
variants/head-drive/Original_foot_R_with_concealed_pulley.stl
variants/4-servo/User_foot_L_-_ankle_fork.stl
variants/direct-drive/Emo-DirectDrive-print.step
variants/foot-drive/Foot_L_-_TPU_rear_axle_cap.stl
emo-complete/Foot_R_-_top_access_lid.stl
variants/foot-drive/Leg_R_-_slim_open_U_fork.stl
variants/head-drive/Axle_retaining_plug_R_-44.5.stl
emo-complete/Foot_L_-_TPU_traction_sole.stl
variants/direct-drive/Foot_R_-_TPU_rear_axle_cap.stl
variants/foot-drive/Foot_L_-_enclosed_flat_MG90S_shoe.stl
variants/head-drive/Axle_retaining_plug_L_-44.5.stl
variants/direct-drive/Leg_R_-_enclosed_direct_MG90S.stl
emo-complete/Leg_R_-_slim_open_U_fork.stl
variants/foot-drive/Foot_R_-_top_access_lid.stl
variants/head-drive/Remote_ankle_drive_drum_R.stl
variants/4-servo/Leg_L_side_cover_-1.stl
variants/direct-drive/Foot_L_-_direct_keyed_drive.stl
variants/foot-drive/Foot_R_-_TPU_rear_axle_cap.stl
variants/4-servo/User_leg_R_-_servo_cradle.stl
variants/direct-drive/Leg_L_-_clip_front_cover.stl
emo-complete/Foot_L_-_TPU_rear_axle_cap.stl
variants/foot-drive/Leg_L_-_slim_open_U_fork.stl
variants/head-drive/Axle_retaining_plug_R_4.5.stl
variants/head-drive/Axle_retaining_plug_L_4.5.stl
variants/head-drive/Original_slim_leg_L.stl
emo-complete/Foot_R_-_TPU_rear_axle_cap.stl
variants/head-drive/Emo-HeadDrive-print.step
emo-complete/Foot_R_-_enclosed_flat_MG90S_shoe.stl
emo-complete/Foot_L_-_top_access_lid.stl
emo-complete/Emo-Complete.f3d
emo-complete/Original-user-backup.f3d
emo-complete/Original_head_-_no_exterior_screws.stl
variants/4-servo/Emo-4servo.f3d
variants/4-servo/Leg_L_side_cover_1.stl
variants/4-servo/Leg_R_side_cover_1.stl
variants/4-servo/Original-user-backup.f3d
variants/direct-drive/Emo-DirectDrive.f3d
variants/direct-drive/Original-user-backup.f3d
variants/direct-drive/Original_head_-_no_exterior_screws.stl
variants/foot-drive/Emo-FootDrive.f3d
variants/foot-drive/Original-user-backup.f3d
variants/foot-drive/Original_head_-_no_exterior_screws.stl
variants/head-drive/Emo-HeadDrive.f3d
variants/head-drive/Original-user-backup.f3d
variants/head-drive/Original_head_-_no_exterior_screws.stl
