vladiclick/emo-desk-robot/figurine/EMO_print_preview.png

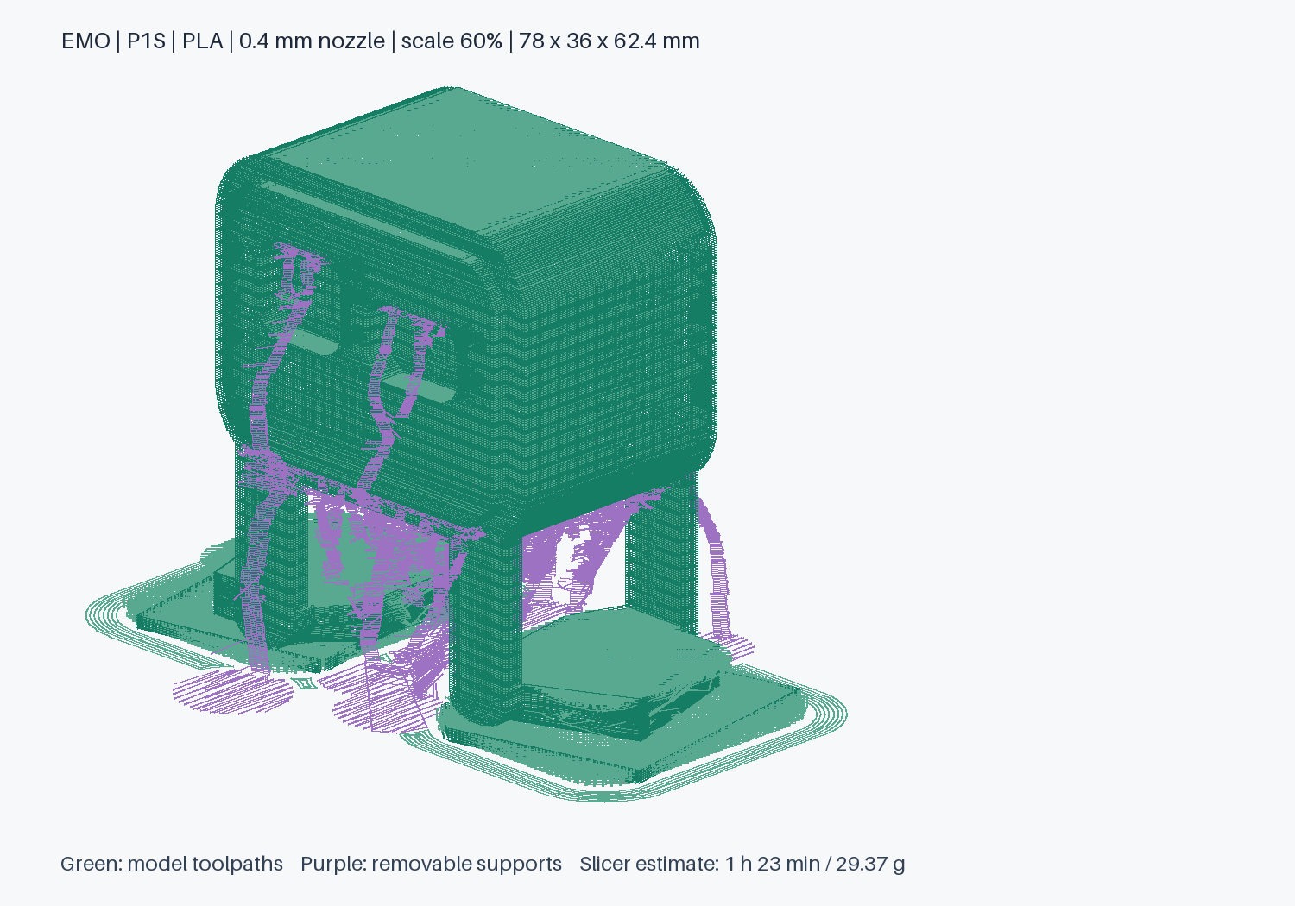
figurine/EMO_print_preview.png
